jocimarweb/Trava_Solenoide_RFID_Arduino/README.md

# Trava Solenoide com RFID Arduino
UMA ARQUITETURA PARA CONTROLE DE ACESSO À AMBIENTES FÍSICOS: Automatização de um sistema de fechadura utilizando Arduino e Android
